Myles-Brown/Simon-With-a-3D-Printed-Controller-and-Joystick/Hardware/Schematic and PCB View/HW-504 internal schematic.png

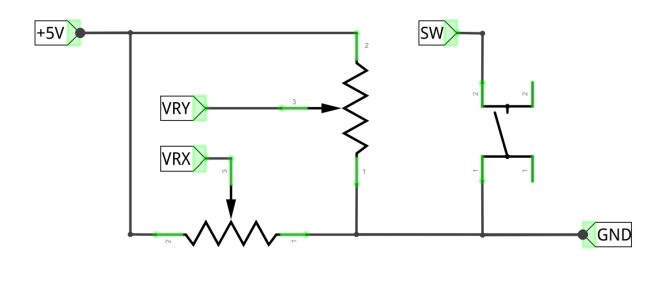
Hardware/Schematic and PCB View/HW-504 internal schematic.png
