Myles-Brown/Simon-With-a-3D-Printed-Controller-and-Joystick/Hardware/Schematic and PCB View/PCB Layout.png

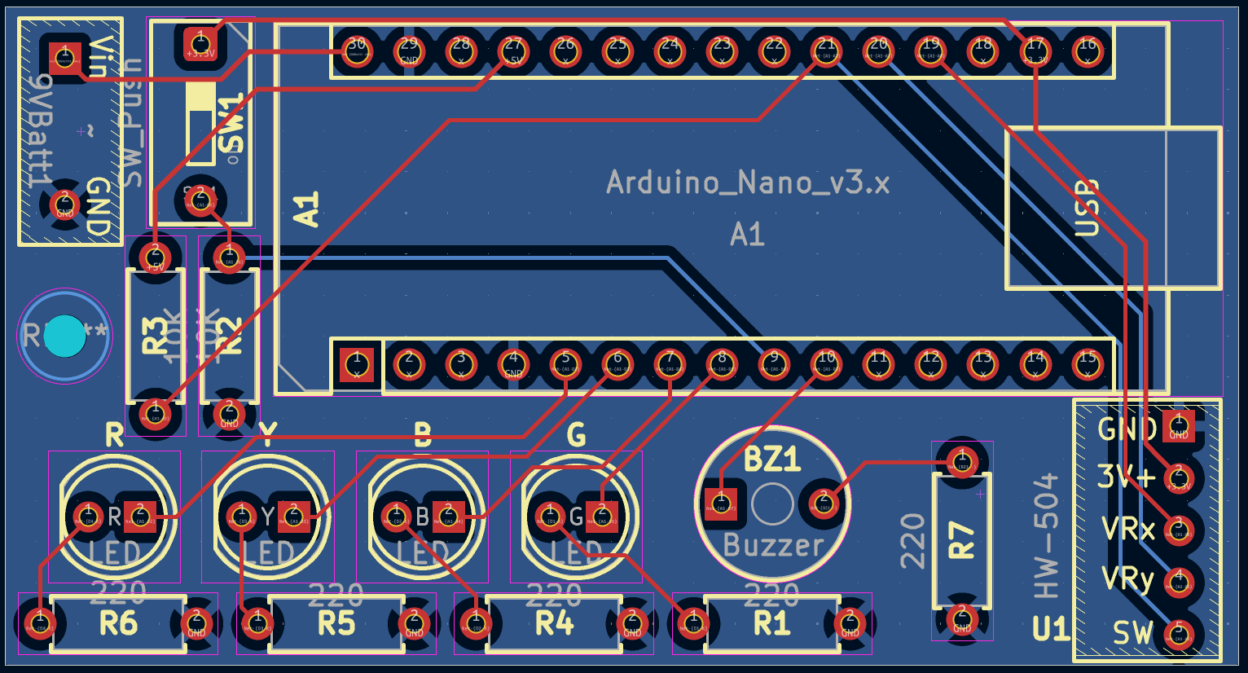
Hardware/Schematic and PCB View/PCB Layout.png
