Myles-Brown/Simon-With-a-3D-Printed-Controller-and-Joystick/Hardware/SimonSays project BOM.csv

Reference | Qty | Value | DNP | Exclude from BOM | Exclude from Board | Footprint | Datasheet/Link to product
9VBatt1 | 1 | ~ |  |  |  | SimonSay_joystick:9V Batt In
A1 | 1 | Arduino_Nano_v3.x |  |  |  | Module:Arduino_Nano | http://www.mouser.com/pdfdocs/Gravitech_Arduino_Nano3_0.pdf
BZ1 | 1 | Buzzer |  |  |  | Buzzer_Beeper:Buzzer_5V | https://www.pcboard.ca/mini-piezo-buzzer
D1,D2,D3,D4 | 4 | LED |  |  |  | LED_THT:LED_D5.0mm | ~
R1,R4,R5,R6,R7 | 5 | 220 |  |  |  | Resistor_THT:R_Axial_DIN0207_L6.3mm_D2.5mm_P7.62mm_Horizontal | ~
R2,R3 | 2 | 10K |  |  |  | Resistor_THT:R_Axial_DIN0207_L6.3mm_D2.5mm_P7.62mm_Horizontal | ~
SW1 | 1 | SW_Push |  |  |  | Button_Switch | https://thepihut.com/products/colorful-square-tactile-button-switch-assortment-15-pack
U1 | 1 | HW-504 |  |  |  | SimonSay_joystick:JoyStick HW-504
~ | 1 | Switch |  |  |  | uxcell 25 Pcs 3 Terminals PCB Mount 2 Position SPDT Mini Slide Switch | https://www.amazon.ca/dp/B00O9YPJKY?sp_csd=d2lkZ2V0TmFtZT1zcF9kZXRhaWw
