Myles-Brown/Simon-With-a-3D-Printed-Controller-and-Joystick/3D Prints/back cover.stl

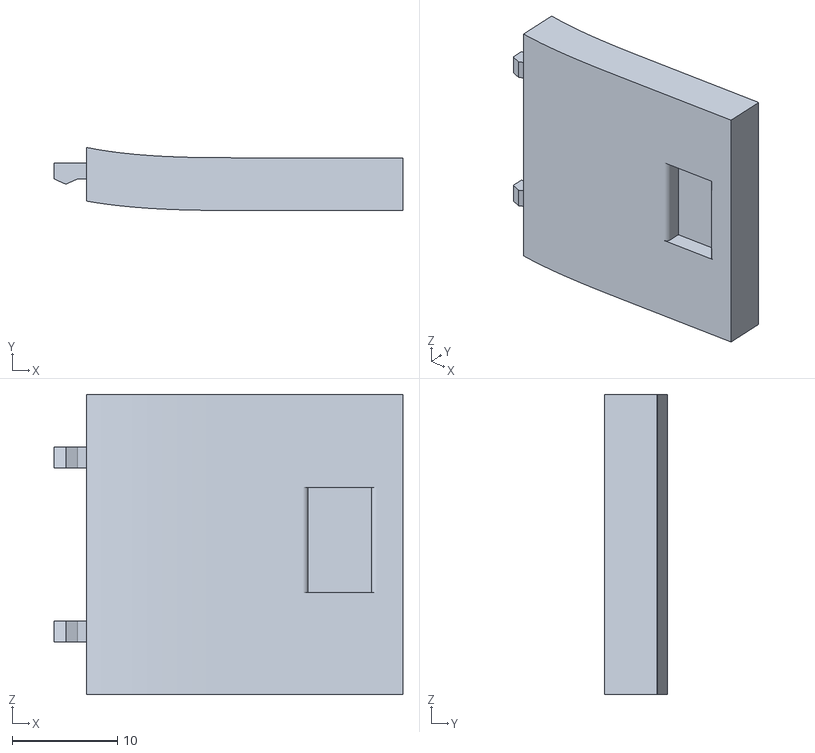
[picture p4: CAD file, 2026-10-08]
3D Prints/back cover.stl
33.1 x 5.98 x 28.5
