Myles-Brown/Simon-With-a-3D-Printed-Controller-and-Joystick/3D Prints/Top.stl

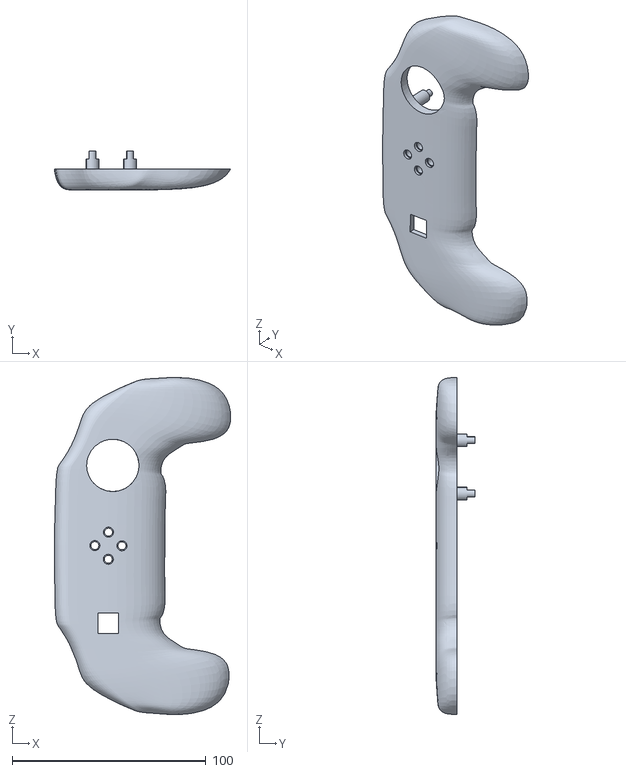
[picture p5: CAD file, 2026-10-08]
3D Prints/Top.stl
91.1 x 20.2 x 174.1
