Myles-Brown/Simon-With-a-3D-Printed-Controller-and-Joystick/3D Prints/Bottom.stl

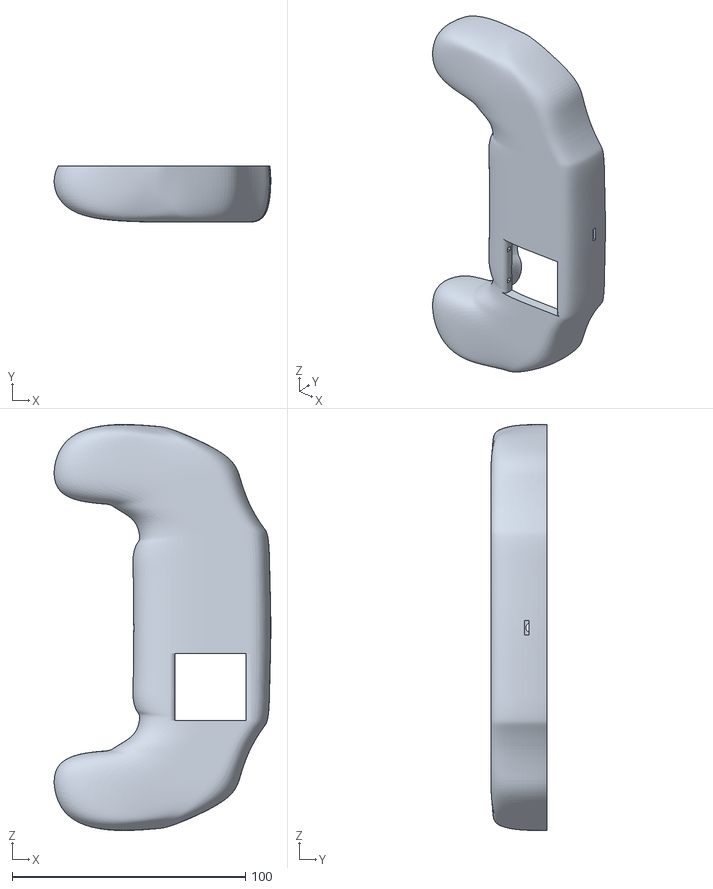
[picture p6: CAD file, 2026-10-08]
3D Prints/Bottom.stl
92.9 x 24.2 x 174.1
