Myles-Brown/Simon-With-a-3D-Printed-Controller-and-Joystick/Hardware/Manufacturing Info.md

# Manufacturing

PCB followed design rules to be manufactured by JLC PCB as a two layer board. To Get the PCB manufactured by them used the ZIP Gerber files found in the Gerbers folder
