Myles-Brown/Simon-With-a-3D-Printed-Controller-and-Joystick/3D Prints/Print Information.md

# Print Orientation
For the best quality prints the top of of the controller should be printed with the outside of the controller facing up.
The bottom piece of the controller should be printed with its outside touching the build plate so the inside of the controller is not deformed.

# Controller Mounting modifications
to keep the joystick connected to four pillars are used to slot through the four holes on the HW-504 joystick module. 
However depending on the exact joystick you use or the vendor the dimensions of the holes on the joystick may slightly vary so it is recommended that 
if a 3d model of the joystick of choice is available you modify the joystick mounting for an exact fit.

# Preview of 3D Model
For the ideal print Orientation the top piece (for right should be flipped around so the bottom faces up).
