Myles-Brown/Simon-With-a-3D-Printed-Controller-and-Joystick/(commit log)

2026-10-08 Create Gerbers
2026-10-08 Create 3D Print
2026-10-08 Create Tools and Assembly
2026-10-08 STL files for the controller
    [Bottom.stl, Top.stl, back cover.stl]
2026-10-08 Update and rename g to Print information
2026-10-08 Add print orientation and joystick mounting instructions
    Added guidelines for print orientation and mounting modifications for the joystick.
2026-10-08 Fix typos and improve formatting in Print Information.md
2026-10-08 Gerbers for PCB
    [SimonSays project-B_Cu.gbl, SimonSays project-B_Mask.gbs, SimonSays project-B_Paste.gbp, SimonSays project-B_Silkscreen.gbo, SimonSays project-Edge_Cuts.gm1, SimonSays project-F_Cu.gtl, SimonSays project-F_Mask.gts, SimonSays project-F_Paste.gtp]
2026-10-08 Document PCB manufacturing information
    Added details about PCB manufacturing process and included an image.
2026-10-08 Add required tools for assembly
2026-10-08 Create Assembly Instructions.md
2026-10-08 Add required tools and assembly instructions to README
    Added a section listing required tools and assembly instructions.
2026-10-08 Update 3D print configuration link in README
2026-10-08 Update 3D print setup link in README
    Updated the link for 3D print setup information to point to the GitHub repository.
2026-10-08 Update README with PCB assembly and BOM links
    Added links for PCB assembly and component list in README.
2026-10-08 Add 9V battery connector to README materials
    Added 9V battery connector to the materials list.
2026-10-08 Rename Screenshot 2026-10-07 194005.png to Schematic Screenshot
2026-10-08 Rename Screenshot 2026-10-08 103910.png to PCB Trace Screenshot
2026-10-08 Add schematic link for component hookup reference
    Added a link to the schematic for component hookup reference.
2026-10-09 Fix schematic link in README
    Updated schematic link to point to the correct repository.
2026-10-09 Add 3D print setup review step to README
    Added a step for reviewing 3D print setup information.
2026-10-09 Update SimonSays project BOM.csv
    [SimonSays project BOM.csv]
2026-10-09 Update Buzzer entry in BOM with new datasheet
    [SimonSays project BOM.csv]
2026-10-09 Fix formatting of BZ1 entry in BOM CSV
    [SimonSays project BOM.csv]
2026-10-09 Modify BOM to add datasheet links
    Updated the BOM to include links to product datasheets.
    [SimonSays project BOM.csv]
2026-10-09 Add new switch component to BOM
    [SimonSays project BOM.csv]
2026-10-10 Update assembly instructions in README
    Added additional instructions for flashing Arduino and clarified component mounting steps.
2026-10-10 Fix spelling and enhance README clarity
    Corrected spelling of 'Controller' and improved clarity in project description and assembly instructions.
2026-10-10 Expand README with features of the Simon game
    Added features section detailing joystick controls, LED and audio feedback, custom enclosure, PCB design, and battery operation.
